juliozohar/Aleph-Flight-Data-Recorder/hardware/board/AlephFDRv100a-Board.png

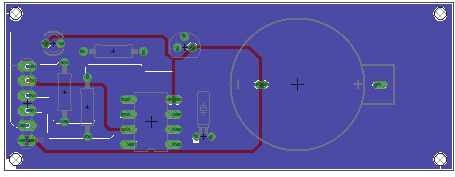
hardware/board/AlephFDRv100a-Board.png
