juliozohar/Aleph-Flight-Data-Recorder/hardware/board/AlephFDRv100a-Schematics.png

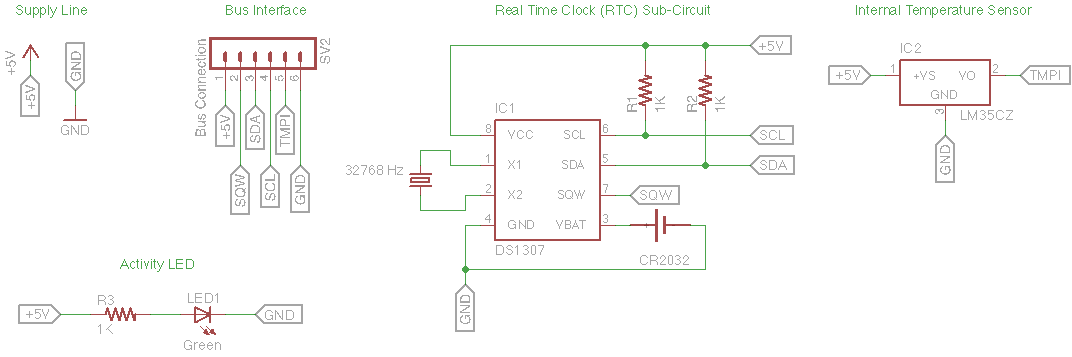
hardware/board/AlephFDRv100a-Schematics.png
