juliozohar/Aleph-Flight-Data-Recorder/hardware/board/AlephFDRv100a.brd

## EAGLE design hardware/board/AlephFDRv100a.brd (2015-03-06)

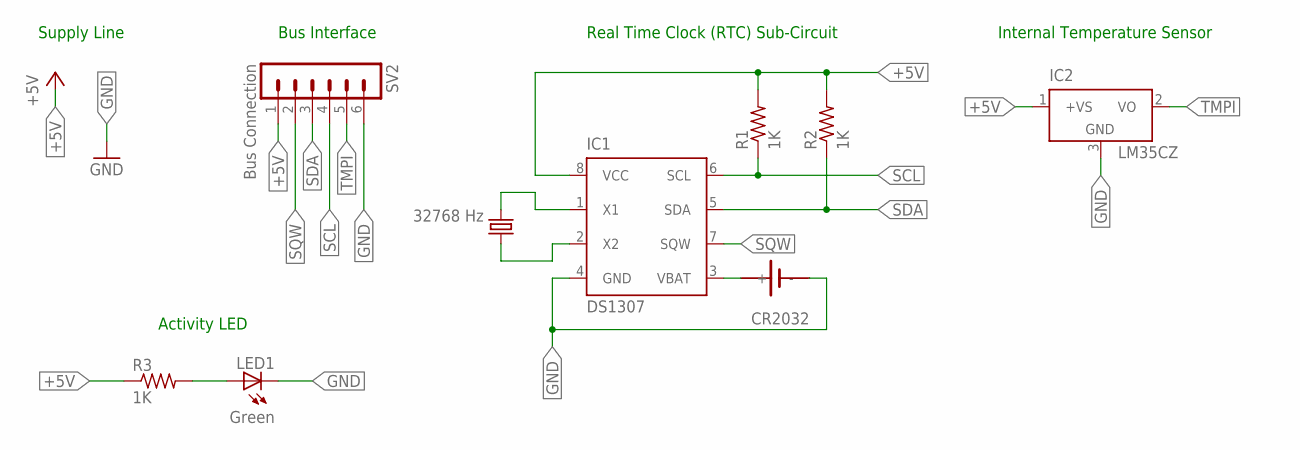
[picture p3: schematic AlephFDRv100a.sch]

Parts:
BAT1: CR2032; SN2032
IC1: DS1307; DIL08
IC2: LM35CZ; TO92
LED1: Green; LED3MM
Q1: 32768 Hz; TC26H
R1, R2, R3: 1K; 0207/10
SV2: Bus Connection; MA06-1

Connections:
+5V: IC1.8 (VCC), IC2.1 (+VS), R1.2, R2.2, R3.1, SV2.1
GND: BAT1.-, IC1.4 (GND), IC2.3 (GND), LED1.K (C), SV2.6
unnamed: LED1.A, R3.2
unnamed: IC1.1 (X1), Q1.2
unnamed: IC1.2 (X2), Q1.1
unnamed: BAT1.+, IC1.3 (VBAT)
SCL: IC1.6 (SCL), R1.1, SV2.4
SDA: IC1.5 (SDA), R2.1, SV2.3
SQW: IC1.7 (SQW), SV2.2
TMPI: IC2.2 (VO), SV2.5

Notes on the sheet:
Activity LED
Real Time Clock (RTC) Sub-Circuit
Supply Line
Bus Interface
Internal Temperature Sensor

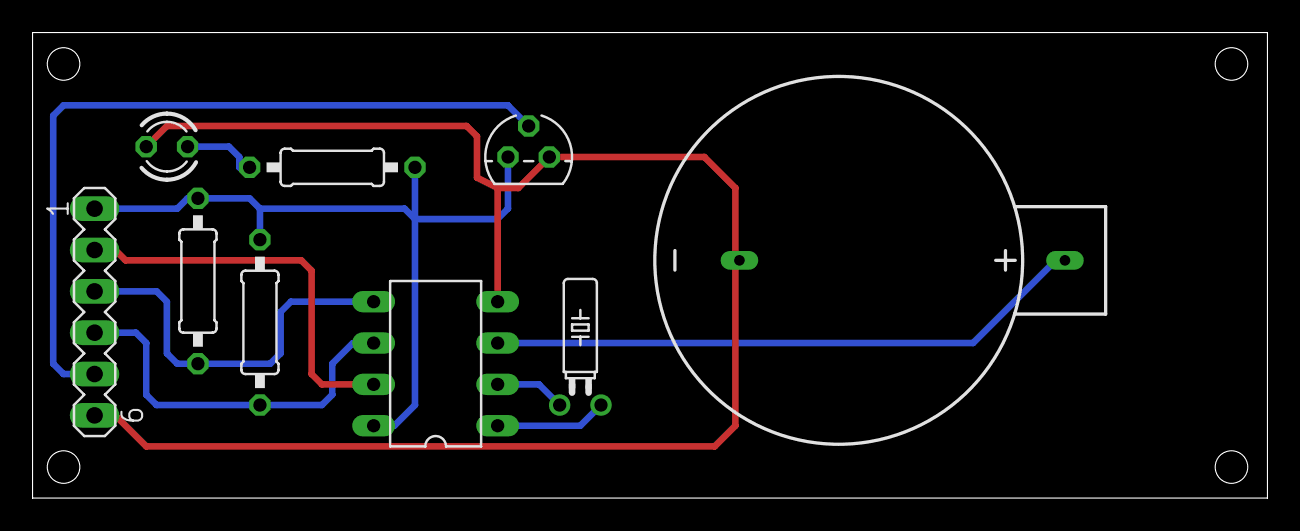
[picture p4: board AlephFDRv100a.brd from above]

Board: 2 copper layers, 75.9 x 28.6 mm, 9 parts (0 on the bottom side), 10 nets.
