juliozohar/Aleph-Flight-Data-Recorder/(commit log)

2015-03-06 Board commit
    [AlephFDRv100a.brd, AlephFDRv100a.sch]
2015-03-06 Fix counter variable.
    Fixes tmp_cont variable for out string size.
    [AlephFRD.ino]
